radhoo/digital_bench_power_supply/digital_bench_power_supply_06.jpg

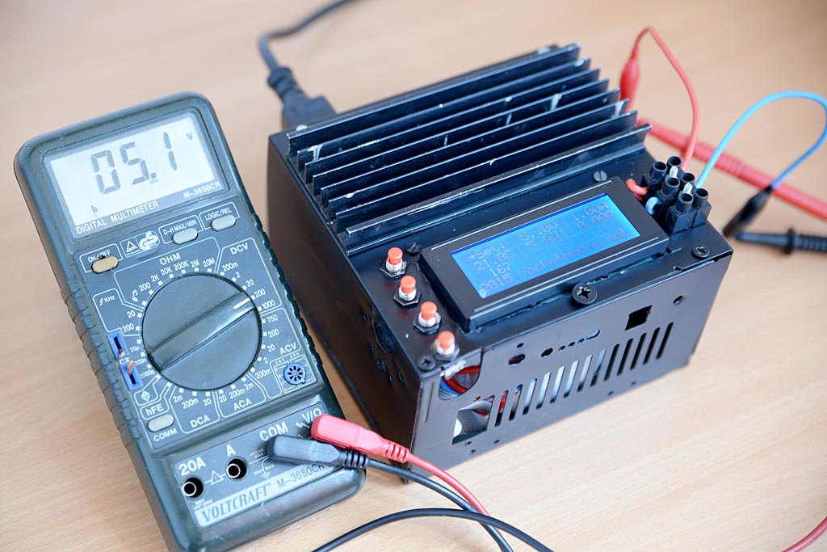
digital_bench_power_supply_06.jpg
