radhoo/digital_bench_power_supply/README.md

# digital_bench_power_supply
A new design for a digital bench power supply built using the Atmega8.

(C) 2015 Radu Motisan, http://www.pocketmagic.net/digital-bench-power-supply/
radu.motisan@gmail.com
