radhoo/digital_bench_power_supply/circuit_diagram_pcb.png

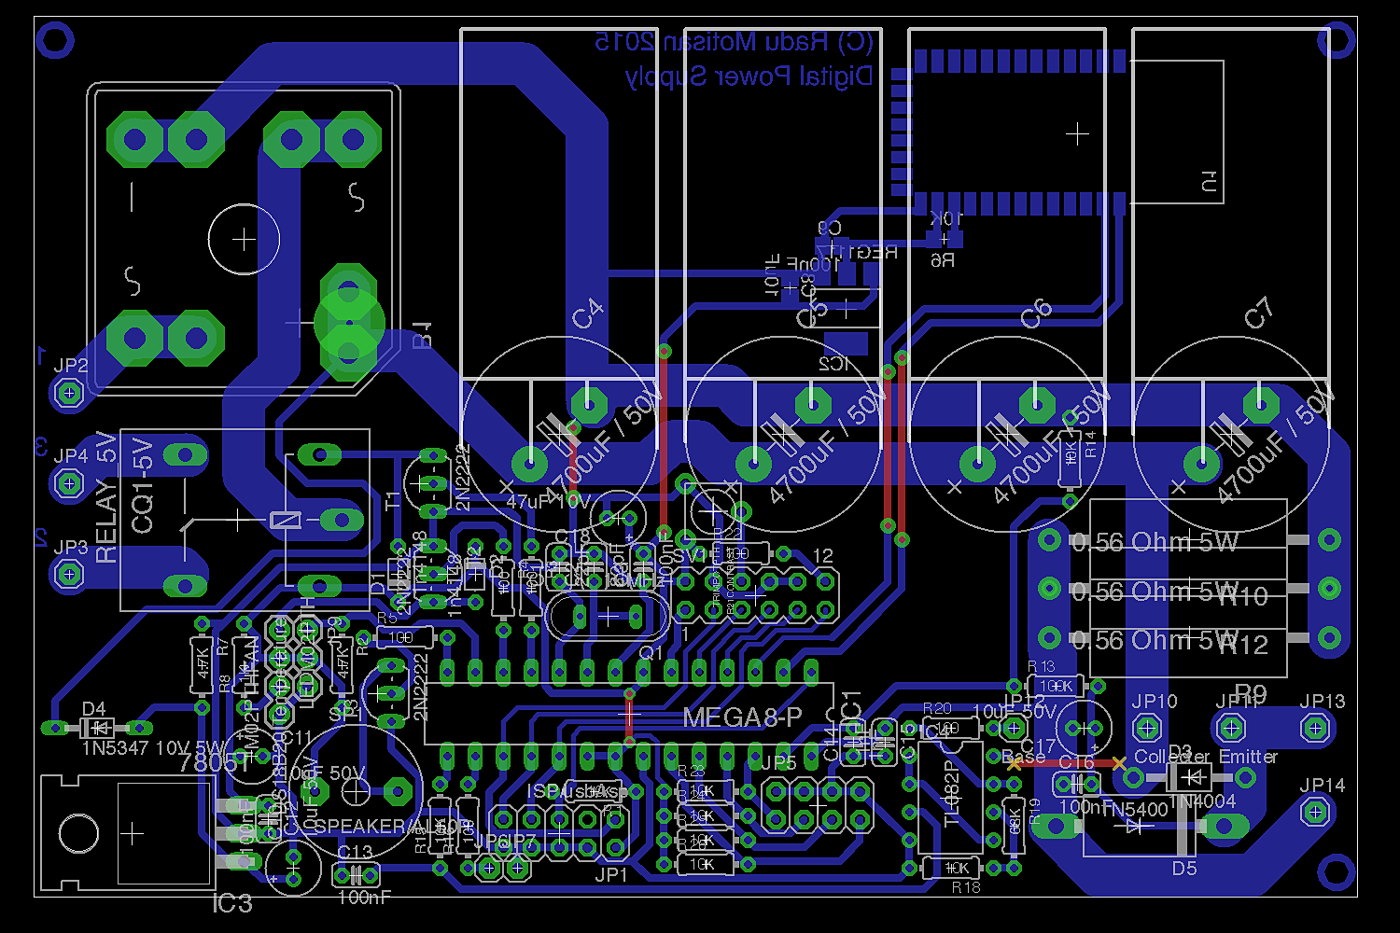
circuit_diagram_pcb.png
