radhoo/digital_bench_power_supply/circuit_diagram_sch.png

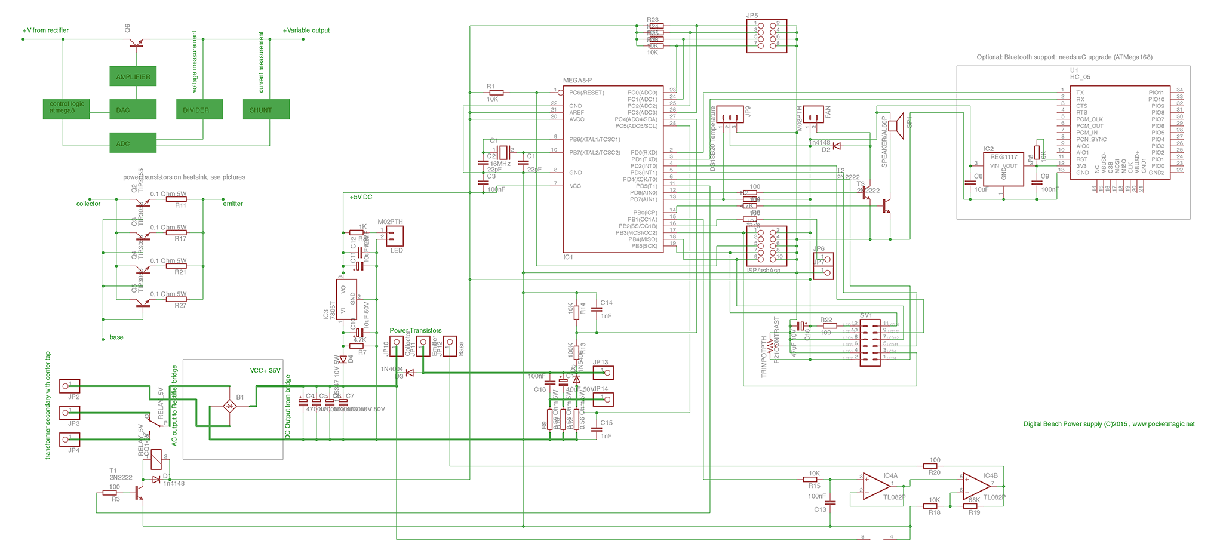
circuit_diagram_sch.png
