radhoo/digital_bench_power_supply/digital_supply_v100.pdf

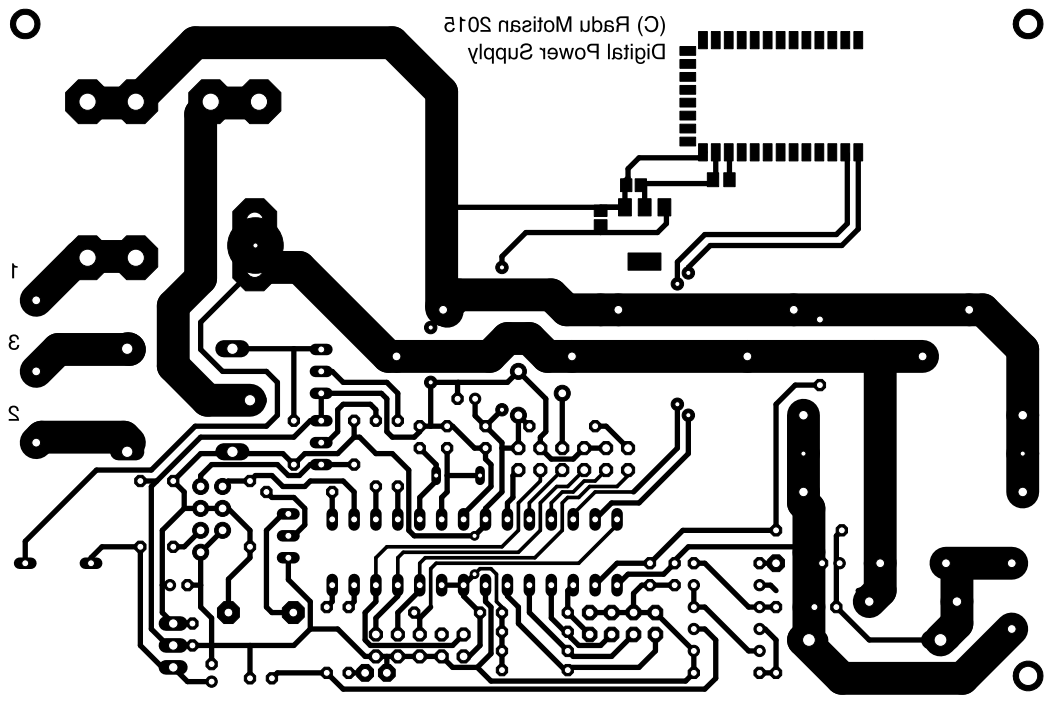
[picture p4: page 1]
