radhoo/digital_bench_power_supply/pcb/100/digital_supply.brd

## EAGLE design pcb/100/digital_supply.brd (2015-04-27)

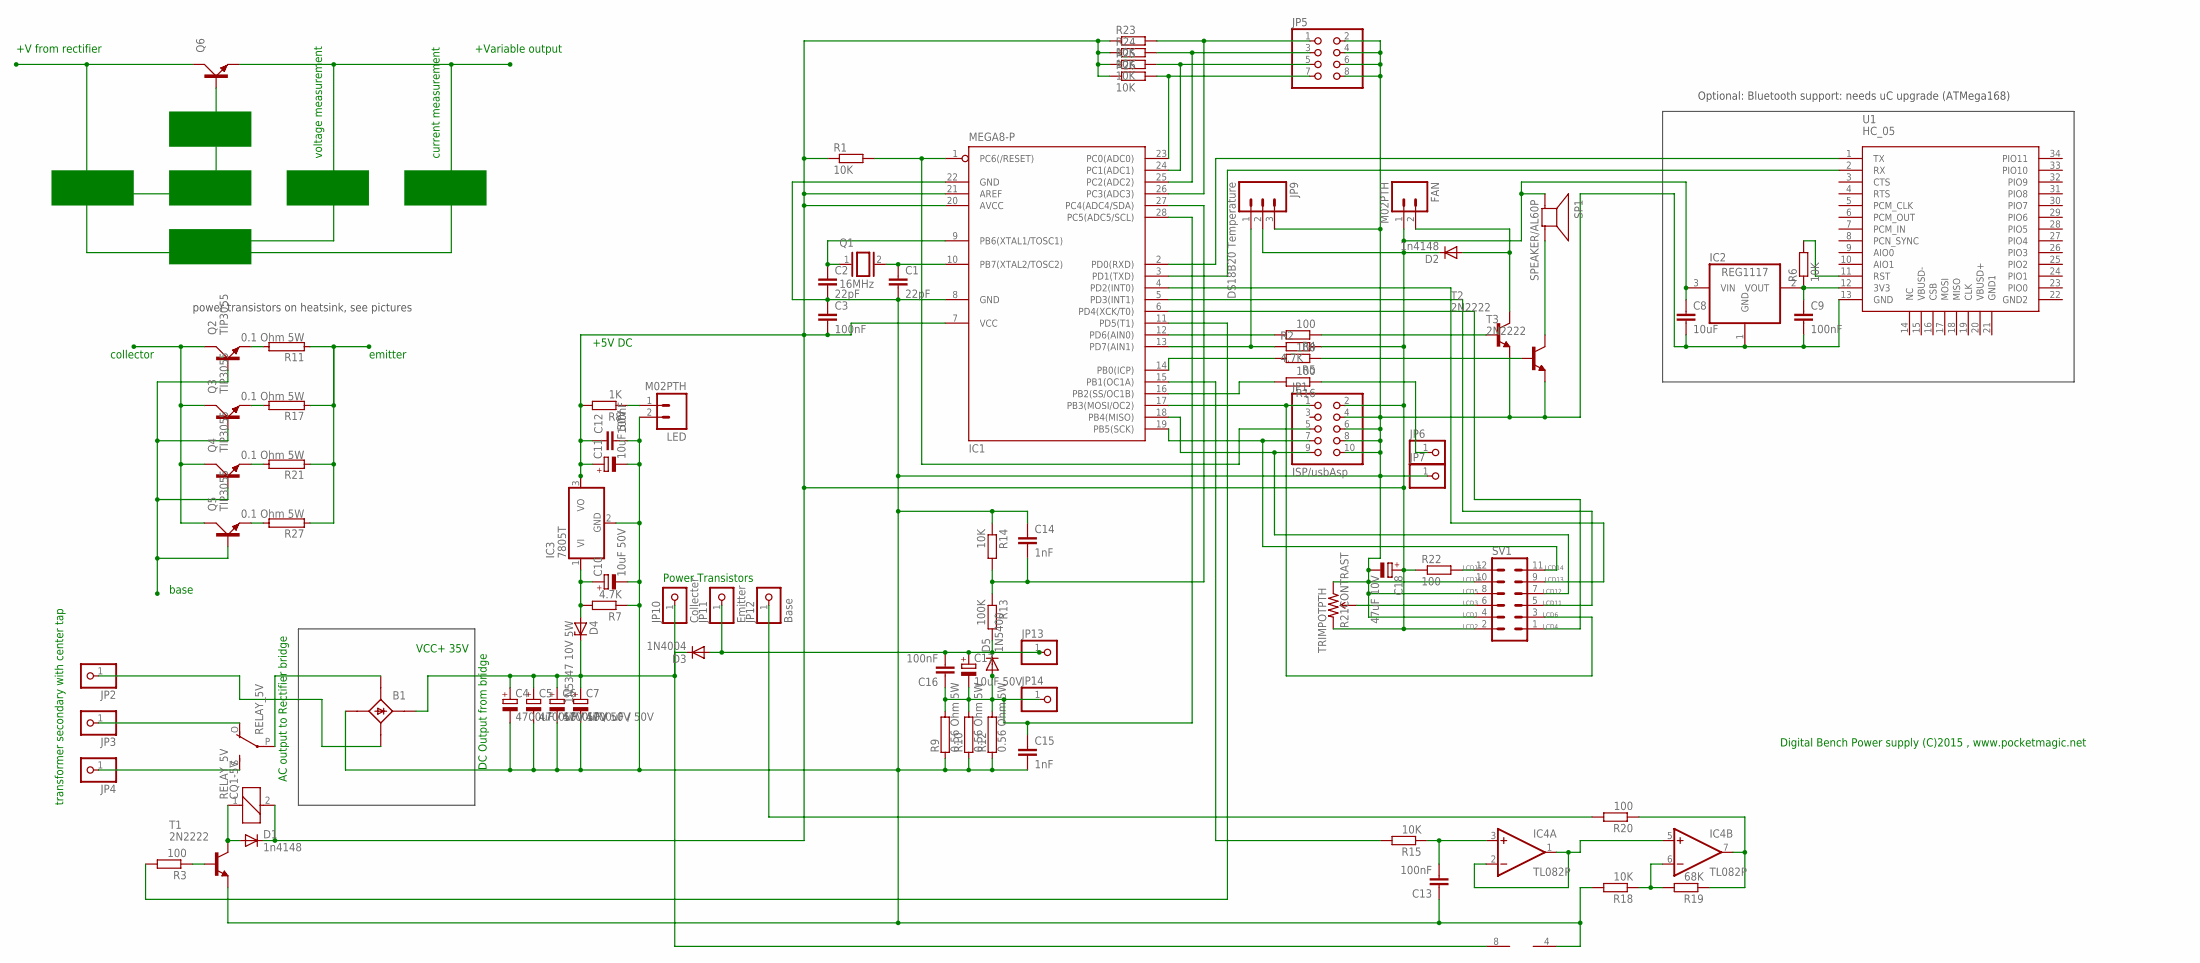
[picture p5: schematic digital_supply.sch]

Parts:
B1: B25A-
C1, C2: 22pF; C025-024X044
C3, C12, C13, C16: 100nF; C025-024X044
C4, C5, C6, C7: 4700uF / 50V; E7,5-18
C8: 10uF; C0805
C9: 100nF; C0805
C10, C11, C17: 10uF 50V; E2-5
C14, C15: 1nF; C025-024X044
C18: 47uF 10V; E2-5
D1, D2: 1n4148; D-5
D3: 1N4004; DO41-10
D4: 1N5347 10V 5W; DO34Z7
D5: 1N5400; DO201-15
FAN: M02PTH; 1X02
IC1: MEGA8-P; DIL28-3
IC2: REG1117; SOT223
IC3: 7805T; TO220H
IC4: TL082P; DIL08
JP1: ISP/usbAsp; 2X05
JP2, JP3, JP4, JP6, JP7, JP13, JP14: PINHD-1X1; 1X01
JP5: PINHD-2X4; 2X04
JP9: DS18B20 Temperature; 1X03
JP10: Collecter; 1X01
JP11: Emitter; 1X01
JP12: Base; 1X01
LED: M02PTH; 1X02
Q1: 16MHz; QS
Q2, Q3, Q4, Q5, Q6: TIP3055; TOP3AV
R1, R14, R15, R18, R23, R24, R25, R26: 10K; 0204/7
R2, R7: 4.7K; 0204/7
R3, R4, R5, R16, R20, R22: 100; 0204/7
R6: 10K; M0805
R8: 1K; 0204/7
R9, R10, R12: 0.56 Ohm 5W; AC05
R11, R17, R21, R27: 0.1 Ohm 5W; AC05
R13: 100K; 0204/7
R19: 68K; 0204/7
R21CONTRAST: TRIMPOTPTH; TRIM_POT_PTH
RELAY_5V: CQ1-5V; G5LE
SP1: SPEAKER/AL60P; AL60P
SV1: MA06-2
T1, T2, T3: 2N2222; TO92-EBC-OVAL
U1: HC_05; BLUETOOTH_SMD

Connections:
unnamed: C1.1, IC1.10 (PB7(XTAL2/TOSC2)), Q1.2
unnamed: C2.1, IC1.9 (PB6(XTAL1/TOSC1)), Q1.1
unnamed: B1.-1 (-), C1.2, C2.2, C3.1, C4.-, C5.-, C6.-, C7.-, C8.2, C9.2, C10.-, C11.-, C12.2, C13.1, C14.1, C15.2, C18.-, IC1.8 (GND), IC1.22 (GND), IC2.1 (GND), IC3.2 (GND), IC4.4 (V-), JP1.4, JP1.6, JP1.8, JP1.10, JP5.2, JP5.4, JP5.6, JP5.8, JP7.1, JP9.3, LED.2, R7.1, R9.1, R10.1, R12.1, R14.1, R18.2, R21CONTRAST.1 (CCW), SV1.4, SV1.8, SV1.10, T1.E, T2.E, T3.E, U1.13 (GND)
unnamed: LED.1, R8.1
unnamed: IC1.1 (PC6(/RESET)), JP1.5, R1.2
unnamed: IC1.17 (PB3(MOSI/OC2)), JP1.1, SV1.3
unnamed: IC1.18 (PB4(MISO)), JP1.9, SV1.7
unnamed: IC1.4 (PD2(INT0)), SV1.9
unnamed: IC1.14 (PB0(ICP)), R5.2
unnamed: IC1.13 (PD7(AIN1)), JP9.1, R2.1
unnamed: JP3.1, RELAY_5V.O
unnamed: JP4.1, RELAY_5V.S
unnamed: B1.AC2- (AC2), JP2.1
unnamed: B1.AC1- (AC1), RELAY_5V.P
unnamed: D1.A, RELAY_5V.1, T1.C
unnamed: B1.+1 (+), C4.+, C5.+, C6.+, C7.+, D3.C, D4.C, IC4.8 (V+), JP10.1
unnamed: R3.1, T1.B
unnamed: IC1.11 (PD5(T1)), R3.2
unnamed: IC1.12 (PD6(AIN0)), R4.2
unnamed: C15.1, C16.1, C17.-, D5.A, IC1.28 (PC5(ADC5/SCL)), JP14.1, R9.2, R10.2, R12.2
unnamed: IC1.15 (PB1(OC1A)), R15.2
unnamed: C14.2, IC1.27 (PC4(ADC4/SDA)), R13.1, R14.2
unnamed: R4.1, T2.B
unnamed: D2.A, FAN.2, T2.C
unnamed: IC1.16 (PB2(SS/OC1B)), R16.2
unnamed: R5.1, T3.B
unnamed: SP1.2 (-), T3.C
unnamed: C16.2, C17.+, D3.A, D5.C, JP11.1, JP13.1, R13.2
unnamed: IC1.2 (PD0(RXD)), U1.1 (TX)
unnamed: IC1.3 (PD1(TXD)), U1.2 (RX)
unnamed: C9.1, IC2.2 (VOUT), R6.1, U1.12 (3V3)
unnamed: C10.+, D4.A, IC3.1 (VI), R7.2
unnamed: R6.2, U1.11 (RST)
unnamed: Q2.E, R11.2
unnamed: JP6.1, R16.1
unnamed: C13.2, IC4.3 (+IN), R15.1
unnamed: IC4.1 (OUT), IC4.2 (-IN), IC4.5 (+IN)
unnamed: IC4.6 (-IN), R18.1, R19.2
unnamed: IC4.7 (OUT), R19.1, R20.1
unnamed: JP12.1, R20.2
unnamed: IC1.6 (PD4(XCK/T0)), SV1.1
unnamed: IC1.5 (PD3(INT1)), SV1.5
unnamed: IC1.19 (PB5(SCK)), JP1.7, SV1.11
unnamed: R21CONTRAST.2 (WIPER), SV1.6
unnamed: R22.2, SV1.12
unnamed: C3.2, C8.1, C11.+, C12.1, C18.+, D1.C, D2.C, FAN.1, IC1.7 (VCC), IC1.20 (AVCC), IC1.21 (AREF), IC2.3 (VIN), IC3.3 (VO), JP1.2, JP9.2, R1.1, R2.2, R8.2, R21CONTRAST.3 (CW), R22.1, R23.1, R24.1, R25.1, R26.1, RELAY_5V.2, SP1.1 (+), SV1.2
unnamed: IC1.26 (PC3(ADC3)), JP5.1, R23.2
unnamed: IC1.25 (PC2(ADC2)), JP5.3, R24.2
unnamed: IC1.24 (PC1(ADC1)), JP5.5, R25.2
unnamed: IC1.23 (PC0(ADC0)), JP5.7, R26.2
unnamed: Q3.E, R17.2
unnamed: Q4.E, R21.2
unnamed: Q5.E, R27.2
unnamed: R11.1, R17.1, R21.1, R27.1
unnamed: Q2.C, Q3.C, Q4.C, Q5.C
unnamed: Q2.B, Q3.B, Q4.B, Q5.B

Notes on the sheet:
transformer secondary with center tap
AC output to Rectifier bridge
DC Output from bridge
VCC+ 35V
+5V DC
Power Transistors
Optional: Bluetooth support: needs uC upgrade (ATMega168)
LCD2 LCD4
LCD1 LCD6
LCD3 LCD11
LCD5 LCD12
LCD16 LCD13
LCD15 LCD14
power transistors on heatsink, see pictures
base
emitter
collector
control logic
+V from rectifier
DAC
ADC
AMPLIFIER
atmega8
SHUNT
+Variable output
voltage measurement
current measurement
DIVIDER
Digital Bench Power supply (C)2015 , www.pocketmagic.net

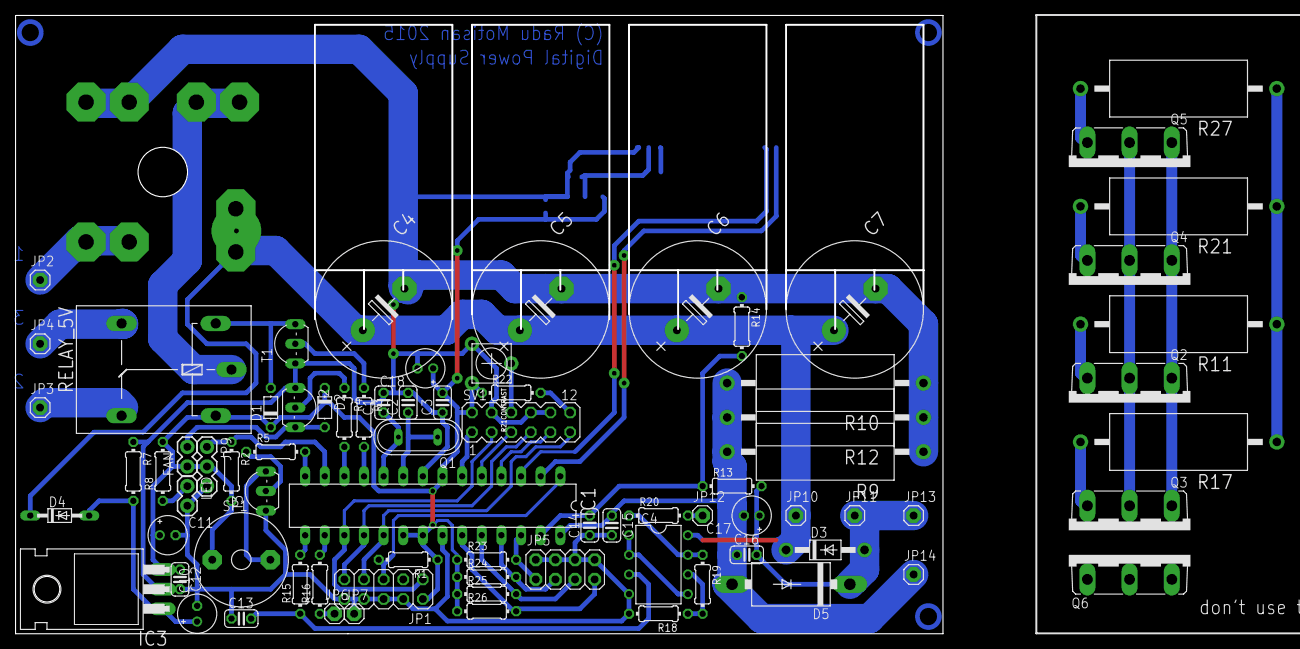
[picture p6: board digital_supply.brd from above]

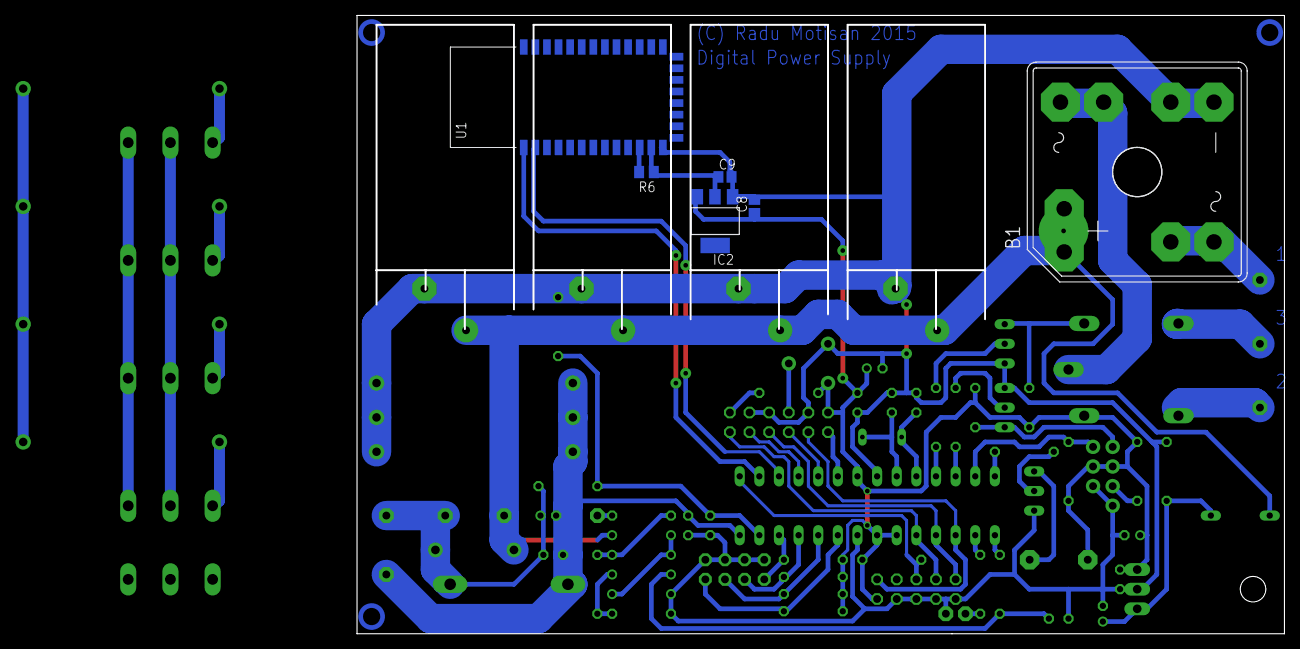
[picture p7: board digital_supply.brd from below]

Board: 2 copper layers, 120.0 x 80.0 mm, 84 parts (6 on the bottom side), 56 nets.
