radhoo/digital_bench_power_supply/(notices)

Notices in the files:
code/main.cpp:
This program is free software; you can redistribute it and/or modify
it under the terms of the GNU General Public License as published by
the Free Software Foundation; either version 2 of the License, or
(at your option) any later version.
parts and their libraries:
sparkfun-connectors: Licensing: CC v3.0 Share-Alike You are welcome to use this library for commercial purposes.
